domenicojbruno/IQP-Resonant-Space/docs/images/TOFpins.png

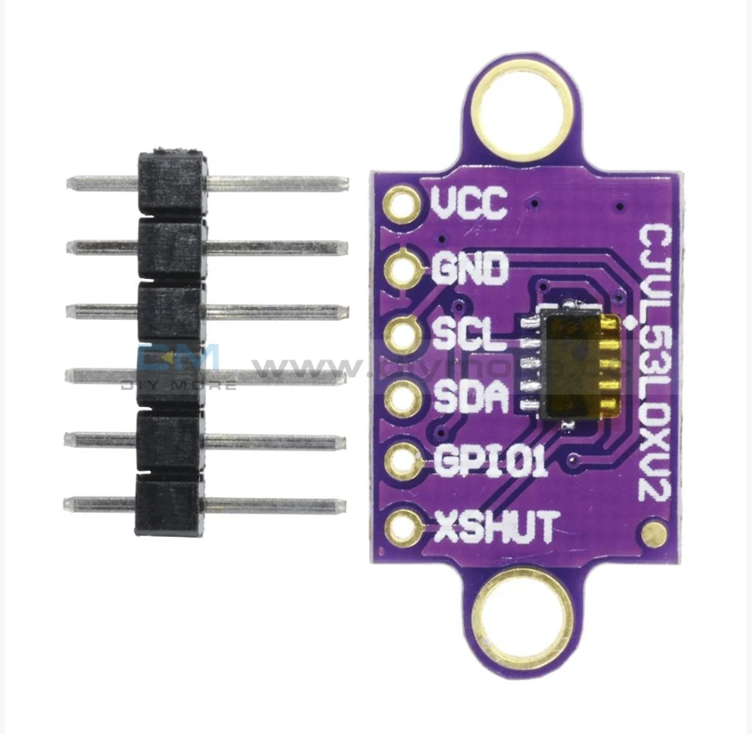
docs/images/TOFpins.png
