domenicojbruno/IQP-Resonant-Space/hardware/motor-driver-board/MotorDriver Board.pdf

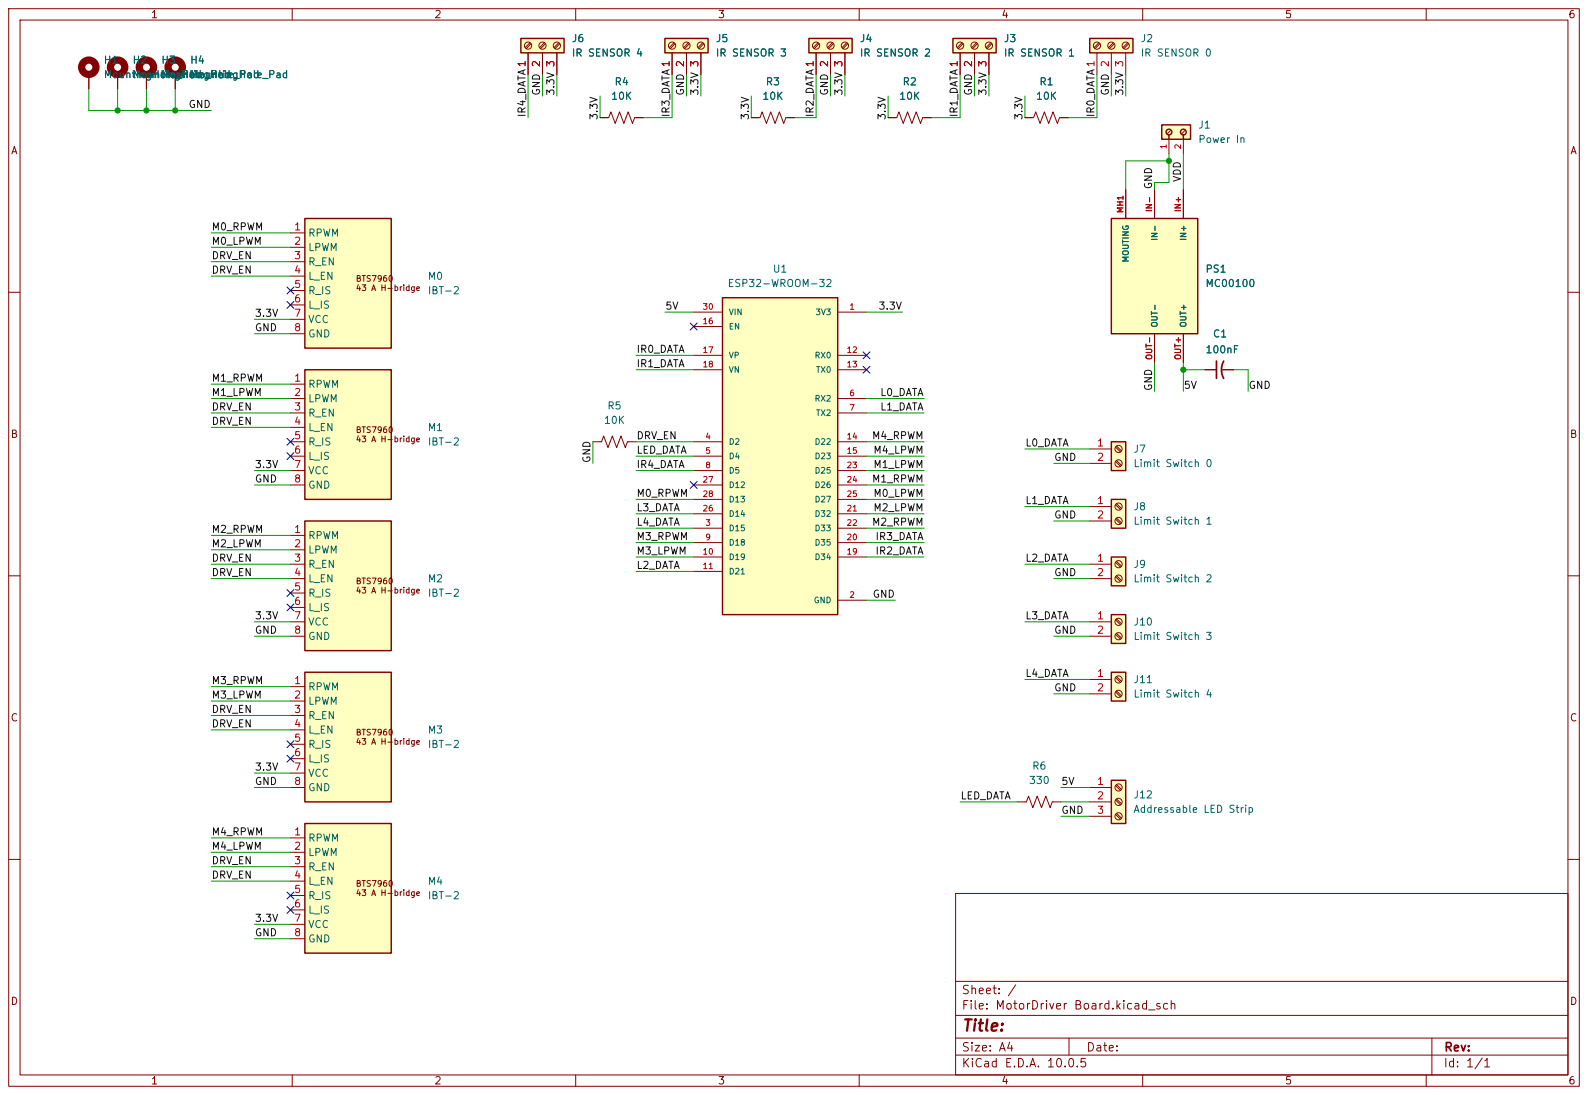
[picture p2: page 1]

Size: A4 | Rev:
KiCad E.D.A. 10.0.5 | Id: 1/1
