domenicojbruno/IQP-Resonant-Space/hardware/motor-driver-board/MotorDriver Board.kicad_pcb

## KiCad design hardware/motor-driver-board/MotorDriver Board.kicad_pcb (2026-09-22)

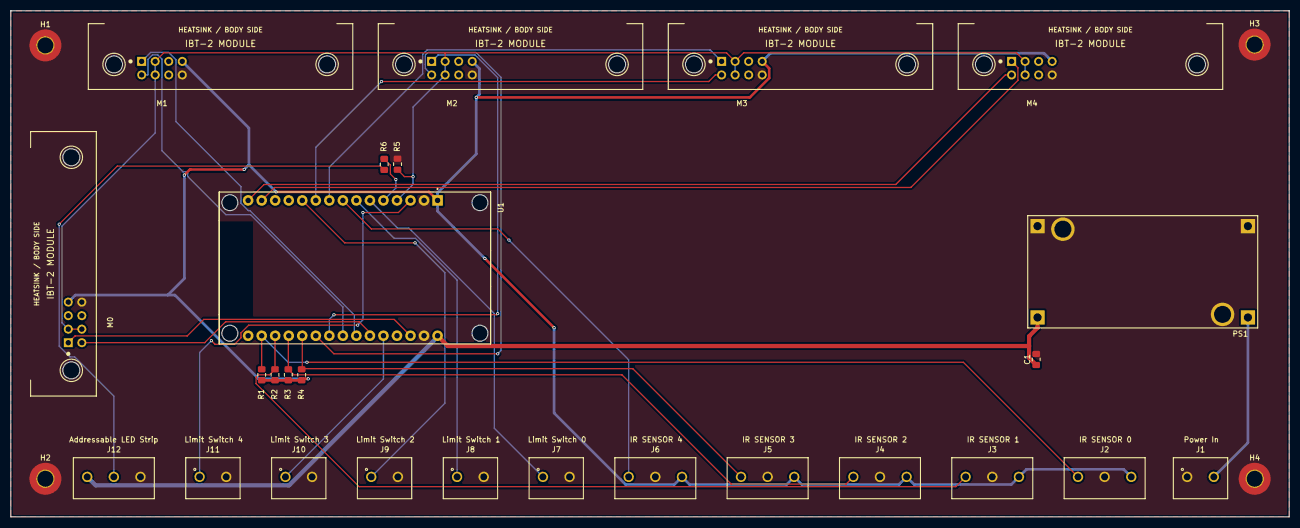
[picture p3: board MotorDriver Board.kicad_pcb from above]

Board: 2 copper layers, 240.0 x 95.0 mm, 30 parts (0 on the bottom side), 27 nets.

Parts:
C1: 100nF; C_0805_2012Metric_Pad1.18x1.45mm_HandSolder
H1, H2, H3, H4: MountingHole_Pad; MountingHole_3mm_Pad_TopBottom
J1: Power In; 691137710002
J2: IR SENSOR 0; 691137710003
J3: IR SENSOR 1; 691137710003
J4: IR SENSOR 2; 691137710003
J5: IR SENSOR 3; 691137710003
J6: IR SENSOR 4; 691137710003
J7: Limit Switch 0; 691137710002
J8: Limit Switch 1; 691137710002
J9: Limit Switch 2; 691137710002
J10: Limit Switch 3; 691137710002
J11: Limit Switch 4; 691137710002
J12: Addressable LED Strip; 691137710003
M0, M1, M2, M3, M4: IBT-2; IBT-2_Header2x04_EdgeOverhang
PS1: MC00100; CONV_MC00100
R1, R2, R3, R4, R5: 10K; C_0805_2012Metric_Pad1.18x1.45mm_HandSolder
R6: 330; C_0805_2012Metric_Pad1.18x1.45mm_HandSolder
U1: ESP32-WROOM-32; MODULE_DEVKIT_V1_ESP32-WROOM-32

Connections:
/3.3V: J2.3, J3.3, J4.3, J5.3, J6.3, M0.7 (VCC), M1.7 (VCC), M2.7 (VCC), M3.7 (VCC), M4.7 (VCC), R1.1, R2.1, R3.1, R4.1, U1.1 (3V3)
/5V: C1.1, J12.1, PS1.OUT+, U1.30 (VIN)
/DRV_EN: M0.3 (R_EN), M0.4 (L_EN), M1.3 (R_EN), M1.4 (L_EN), M2.3 (R_EN), M2.4 (L_EN), M3.3 (R_EN), M3.4 (L_EN), M4.3 (R_EN), M4.4 (L_EN), R5.2, U1.4 (D2)
/IR0_DATA: J2.1, R1.2, U1.17 (VP)
/IR1_DATA: J3.1, R2.2, U1.18 (VN)
/IR2_DATA: J4.1, R3.2, U1.19 (D34)
/IR3_DATA: J5.1, R4.2, U1.20 (D35)
/IR4_DATA: J6.1, U1.8 (D5)
/L0_DATA: J7.1, U1.6 (RX2)
/L1_DATA: J8.1, U1.7 (TX2)
/L2_DATA: J9.1, U1.11 (D21)
/L3_DATA: J10.1, U1.26 (D14)
/L4_DATA: J11.1, U1.3 (D15)
/LED_DATA: R6.1, U1.5 (D4)
/M0_LPWM: M0.2 (LPWM), U1.25 (D27)
/M0_RPWM: M0.1 (RPWM), U1.28 (D13)
/M1_LPWM: M1.2 (LPWM), U1.23 (D25)
/M1_RPWM: M1.1 (RPWM), U1.24 (D26)
/M2_LPWM: M2.2 (LPWM), U1.21 (D32)
/M2_RPWM: M2.1 (RPWM), U1.22 (D33)
/M3_LPWM: M3.2 (LPWM), U1.10 (D19)
/M3_RPWM: M3.1 (RPWM), U1.9 (D18)
/M4_LPWM: M4.2 (LPWM), U1.15 (D23)
/M4_RPWM: M4.1 (RPWM), U1.14 (D22)
/VDD: J1.2, PS1.IN+
GND: C1.2, H1.1 (1_1), H2.1 (1_1), H3.1 (1_1), H4.1 (1_1), J1.1, J2.2, J3.2, J4.2, J5.2, J6.2, J7.2, J8.2, J9.2, J10.2, J11.2, J12.3, M0.8 (GND), M1.8 (GND), M2.8 (GND), M3.8 (GND), M4.8 (GND), PS1.IN-, PS1.MH1 (MOUTING), PS1.MH2 (MOUTING), PS1.OUT-, R5.1, U1.2 (GND), U1.29 (GND)
unnamed: J12.2, R6.2
